csesarah/Rehabot2.0/misc/calib_img-5.jpg

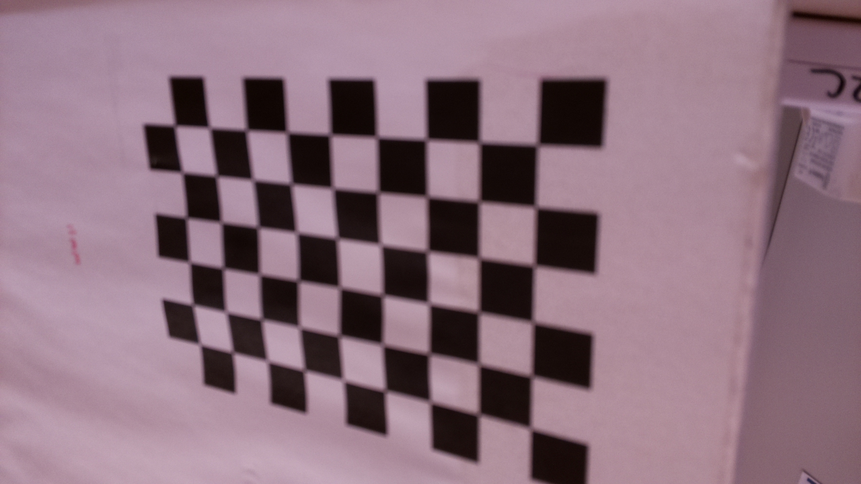
misc/calib_img-5.jpg
