csesarah/Rehabot2.0/misc/calib_img-4.jpg

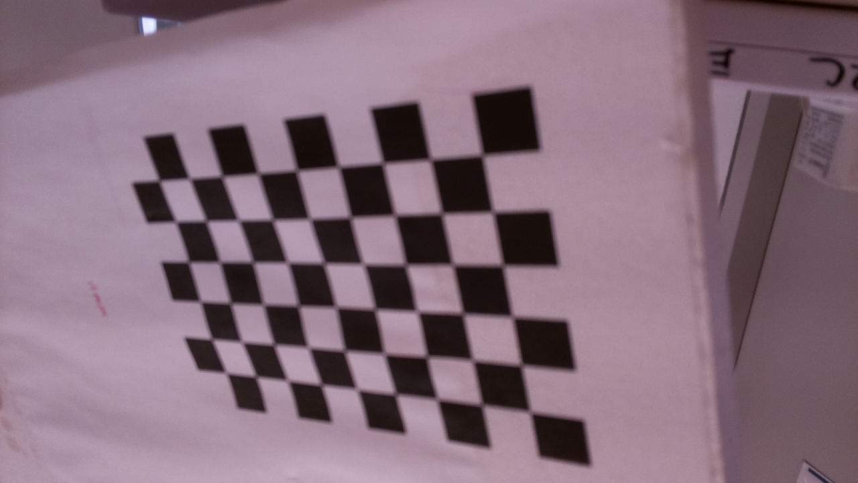
misc/calib_img-4.jpg
