csesarah/Rehabot2.0/misc/calib_img-0.jpg

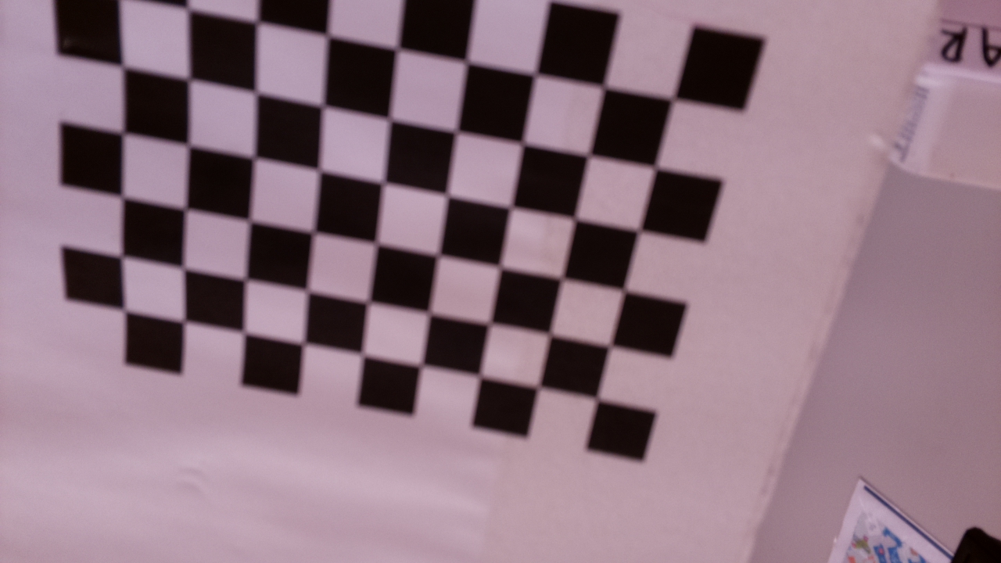
misc/calib_img-0.jpg
