csesarah/Rehabot2.0/misc/calib_img-1.jpg

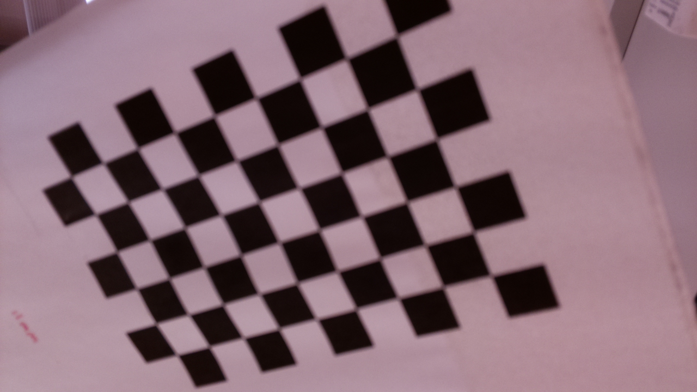
misc/calib_img-1.jpg
