csesarah/Rehabot2.0/misc/calib_img-2.jpg

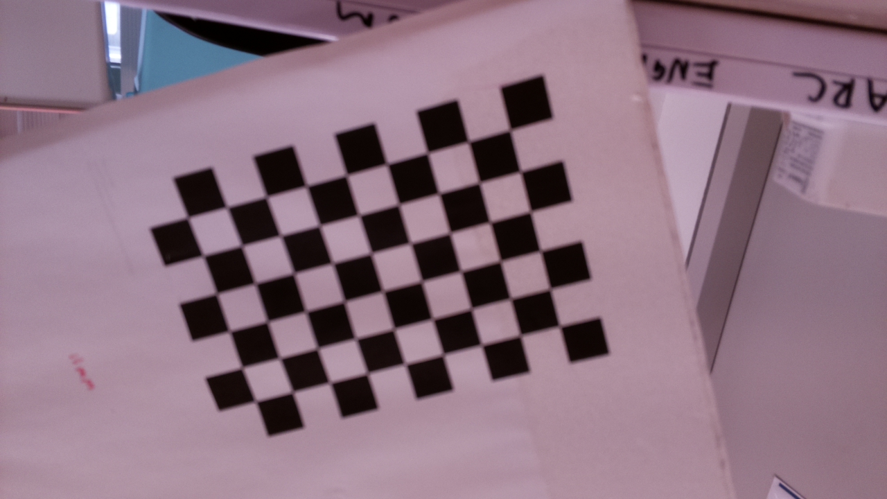
misc/calib_img-2.jpg
