csesarah/Rehabot2.0/misc/calib_img-3.jpg

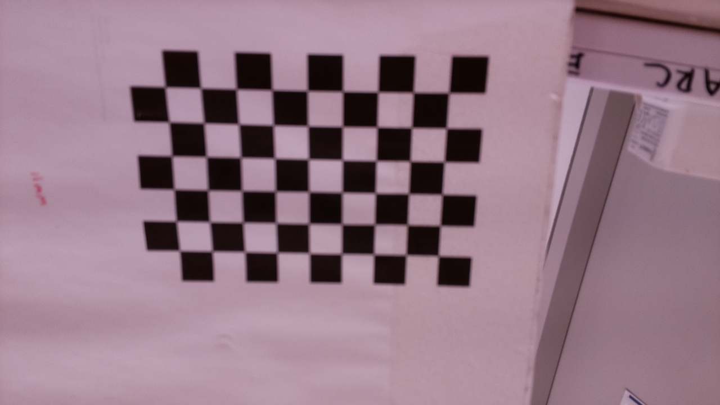
misc/calib_img-3.jpg
