csesarah/Rehabot2.0/misc/calib_img-6.jpg

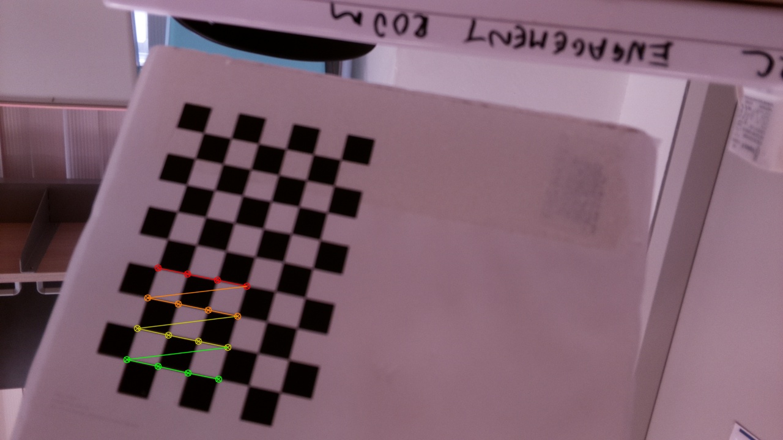
misc/calib_img-6.jpg
