csesarah/Rehabot2.0/misc/calib_img-7.jpg

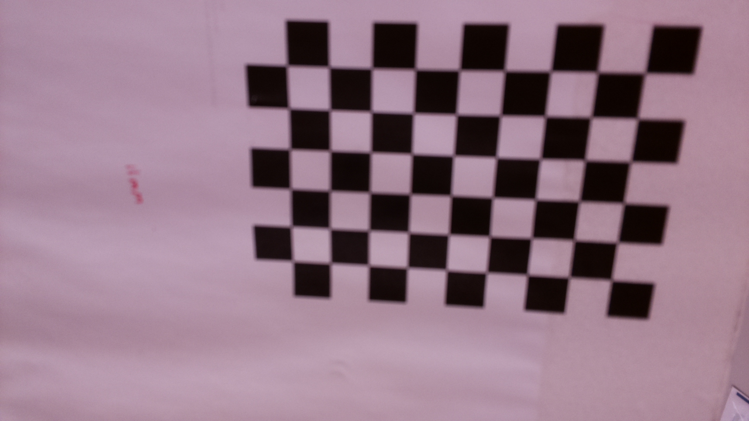
misc/calib_img-7.jpg
