csesarah/Rehabot2.0/misc/calib_img-8.jpg

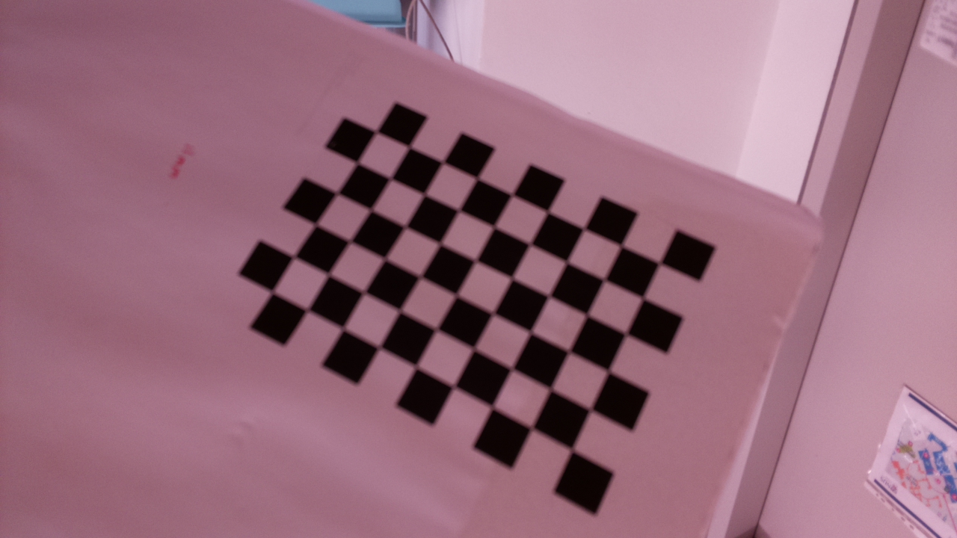
misc/calib_img-8.jpg
