csesarah/Rehabot2.0/misc/calib_img-9.jpg

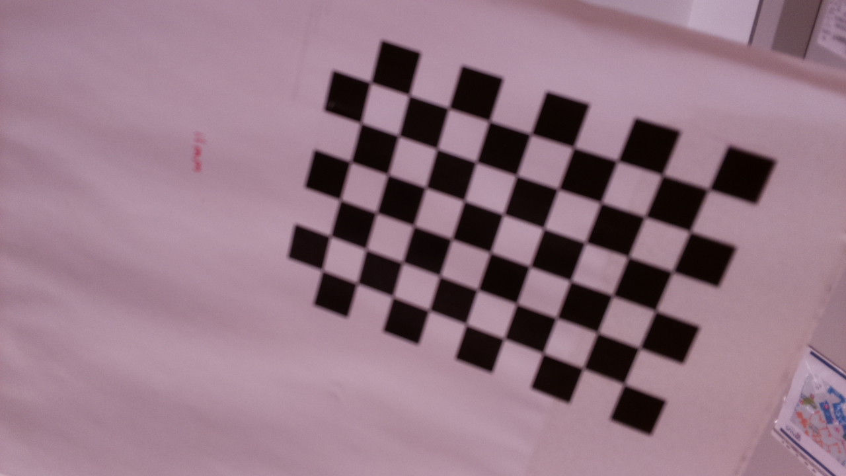
misc/calib_img-9.jpg
