csesarah/Rehabot2.0/rsc/img/wallpaper.png

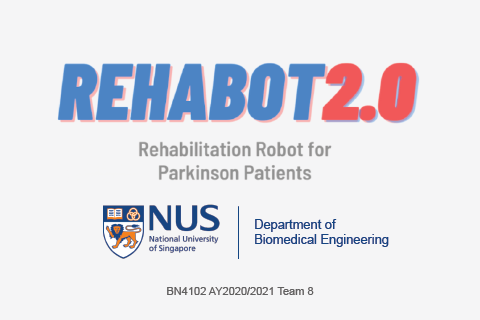
rsc/img/wallpaper.png
