csesarah/Rehabot2.0/ProductionManual.pdf

Rehabot2.0 Production Manual

1. 3D-print and preprocess casings and parts

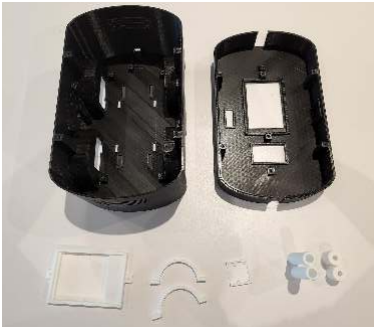
[picture p12: figure]

### 2. Print ArUco markers with IDs 0 and 1, and dictionary size of 5x5

### 3. Fold and tape paper markers and attach velcro to back of marker

### 4. Sew buckle and velcro to elastic bands as shown

### 5. Attach black support pieces to the motors

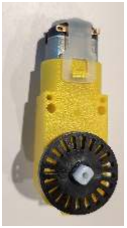
[picture p13: figure]

### 6. Solder wires to motors, and ensure that there are no exposed wires

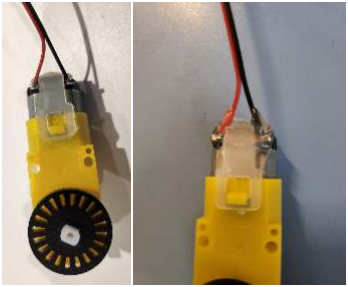
[picture p14: figure]

### 7. Attach motors to bottom casing with holders included in 4-wheel drive set

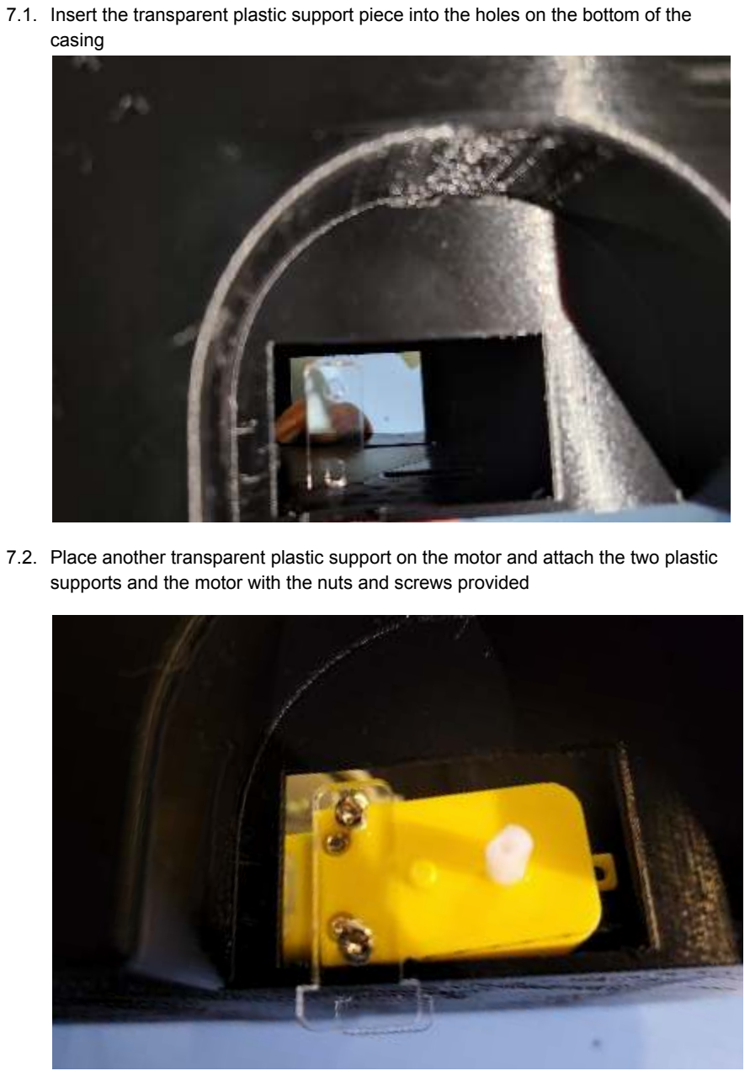
[picture p15: page 3]

### 7.1. Insert the transparent plastic support piece into the holes on the bottom of the

casing

### 7.2. Place another transparent plastic support on the motor and attach the two plastic

supports and the motor with the nuts and screws provided

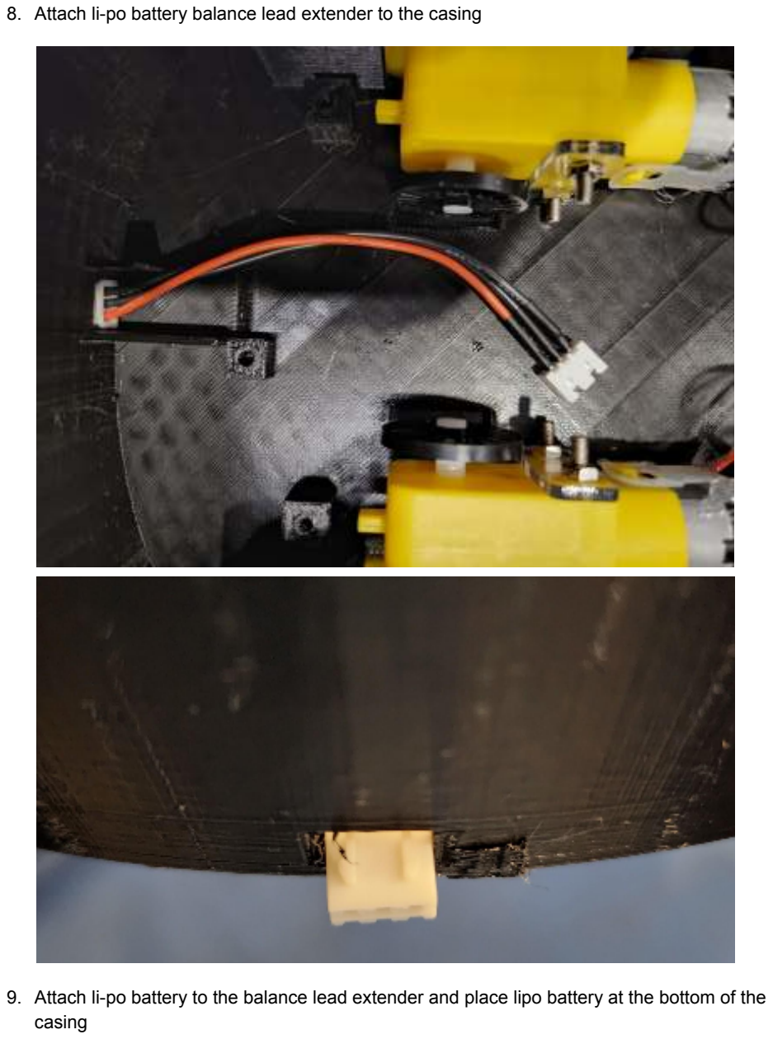
[picture p16: page 4]

### 8. Attach li-po battery balance lead extender to the casing

9. Attach li-po battery to the balance lead extender and place lipo battery at the bottom of the casing

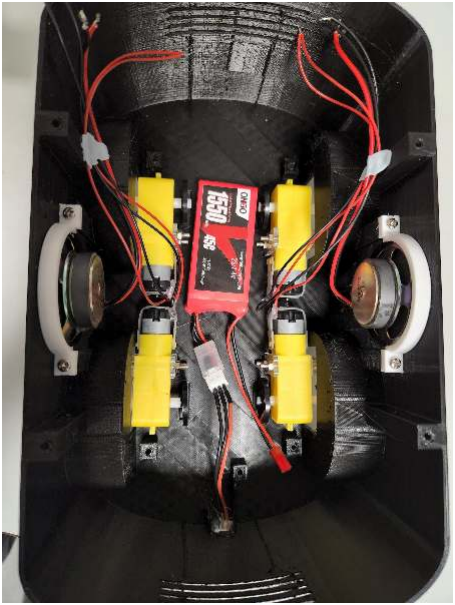
[picture p17: figure]

### 10. Screw support structure onto the bottom casing

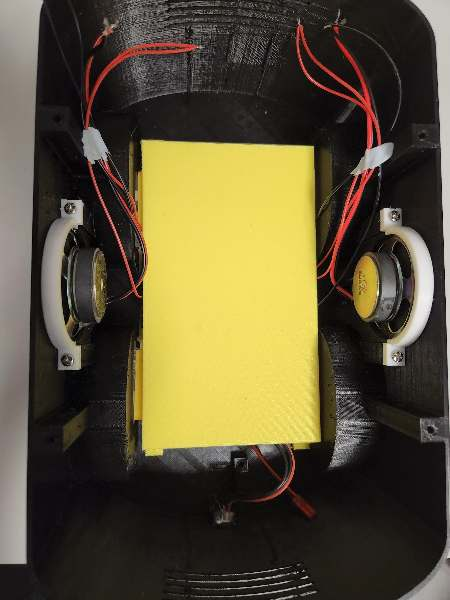
[picture p18: figure]

### 11. Solder the XL6009 step-up, LM2596 step-down, and 5V/3A USB step-down boards onto a

protoboard as shown

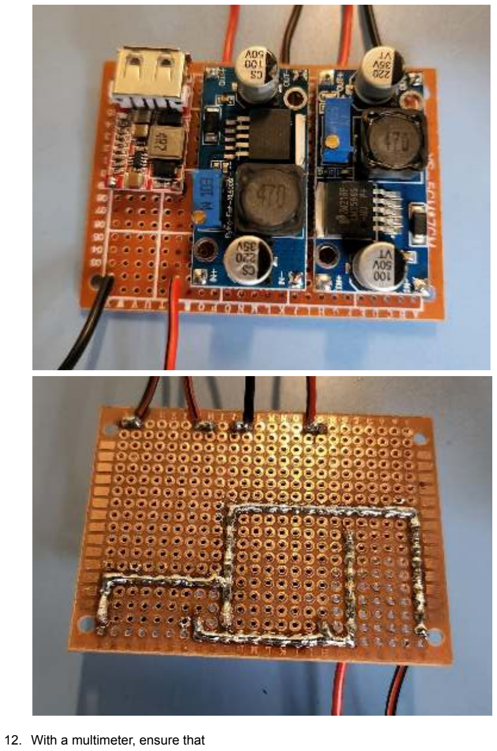
[picture p19: page 7]

### 12. With a multimeter, ensure that

### 12.1. Output voltage of the XL6009 is 12.0V, and

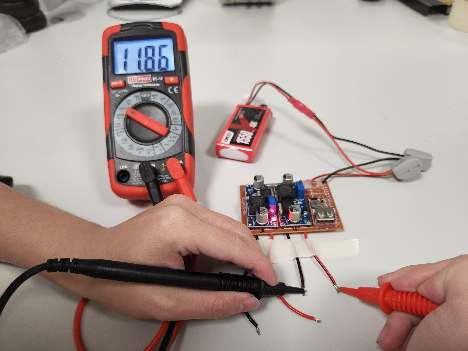
[picture p20: figure]

### 12.2. Output voltage of the LM2596 is 5.0V

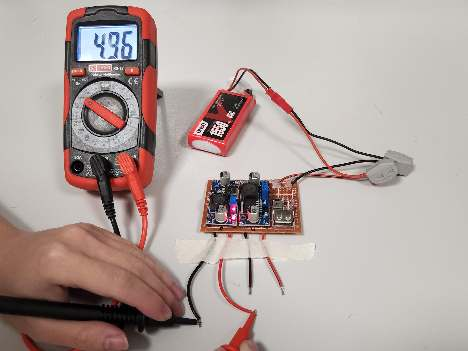
[picture p21: figure]

13. Unscrew the housing from the 3.5mm audio jack and solder the 3.5mm audio jack as shown, wherein ground is the longest terminal, and left and right are the terminals next to the ground terminal respectively

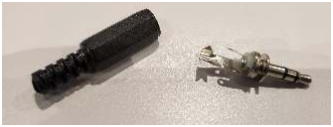
[picture p22: figure]
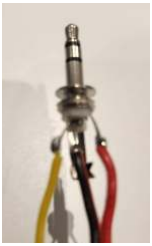
[picture p23: figure]

### 14. Thread audio jack housing through the audio cables and then solder the cables to the

PAM8403 speaker amplifier board

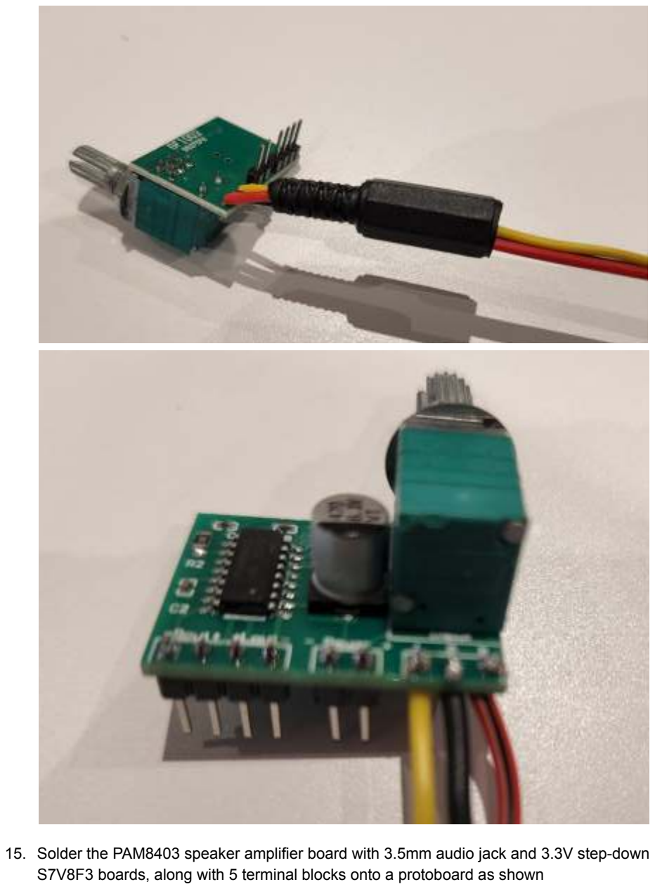
[picture p24: page 11]

### 15. Solder the PAM8403 speaker amplifier board with 3.5mm audio jack and 3.3V step-down

S7V8F3 boards, along with 5 terminal blocks onto a protoboard as shown

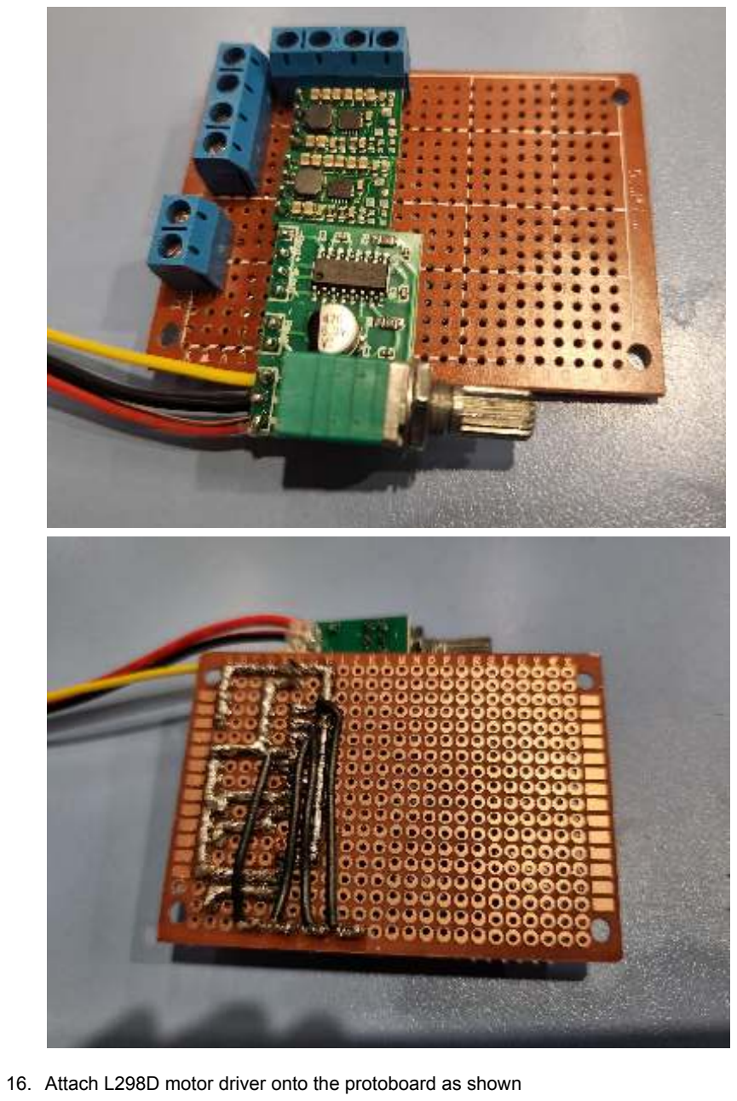
[picture p25: page 12]

### 16. Attach L298D motor driver onto the protoboard as shown

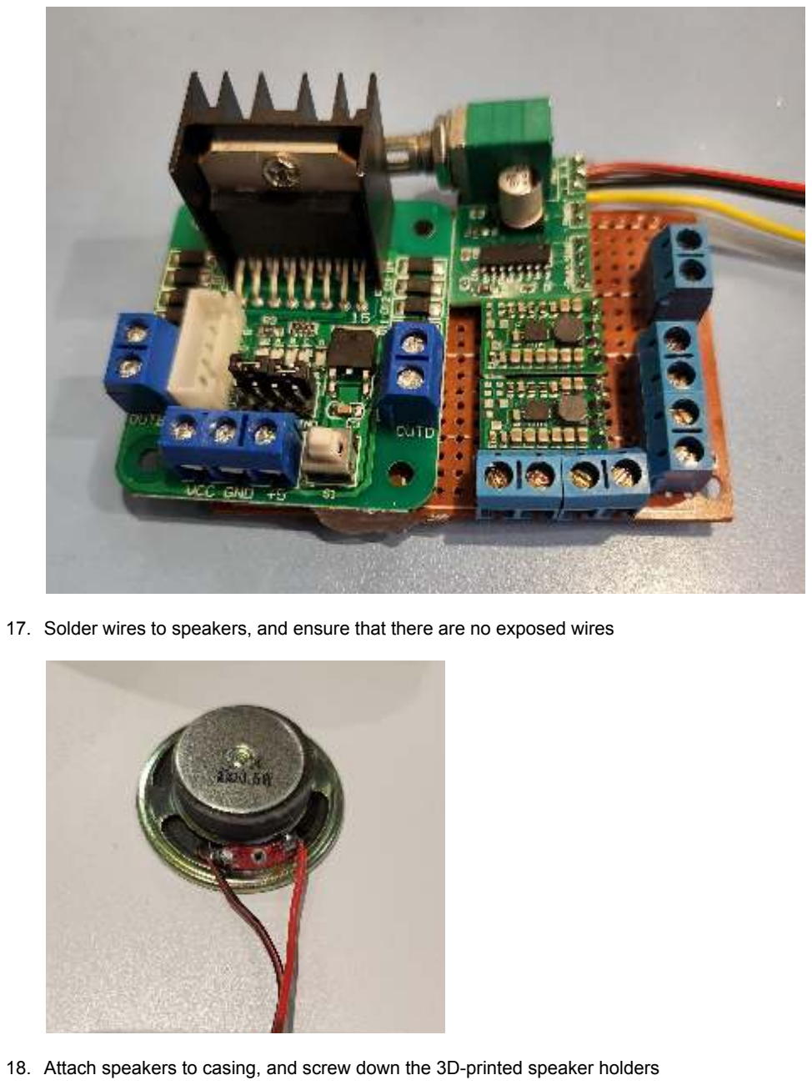
[picture p26: page 13]

### 17. Solder wires to speakers, and ensure that there are no exposed wires

### 18. Attach speakers to casing, and screw down the 3D-printed speaker holders

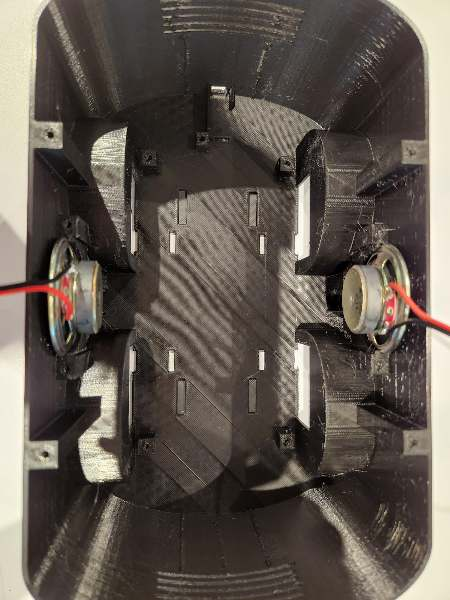
[picture p27: figure]

### 19. Connect the XL6009 step-up (12.0 V) to the motor driver as shown

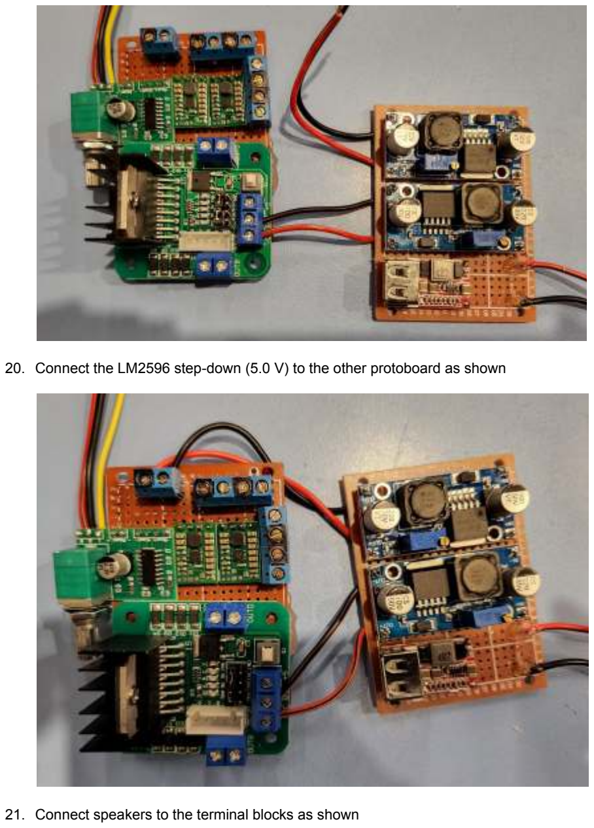
[picture p28: page 15]

### 20. Connect the LM2596 step-down (5.0 V) to the other protoboard as shown

### 21. Connect speakers to the terminal blocks as shown

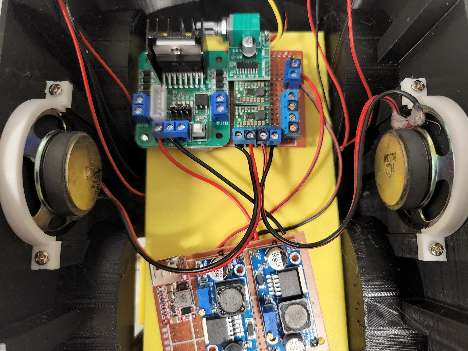
[picture p29: figure]

### 22. Connect motors to the motor driver as shown

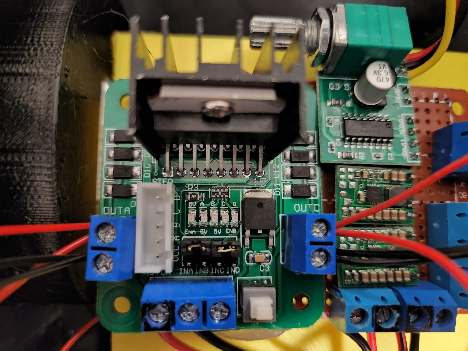
[picture p30: figure]

### 23. Attach line grating on to the green dot lasers

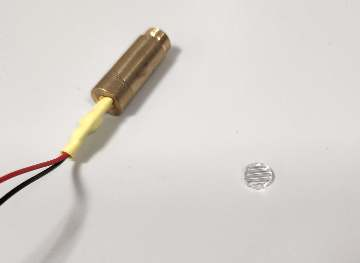
[picture p31: figure]

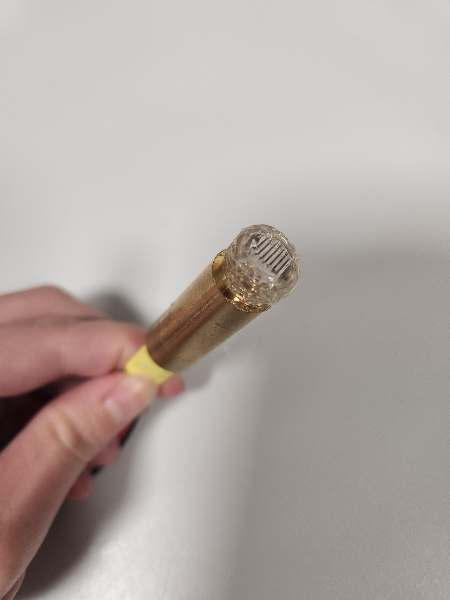
[picture p32: figure]

### 24. Place lasers in the laser holders

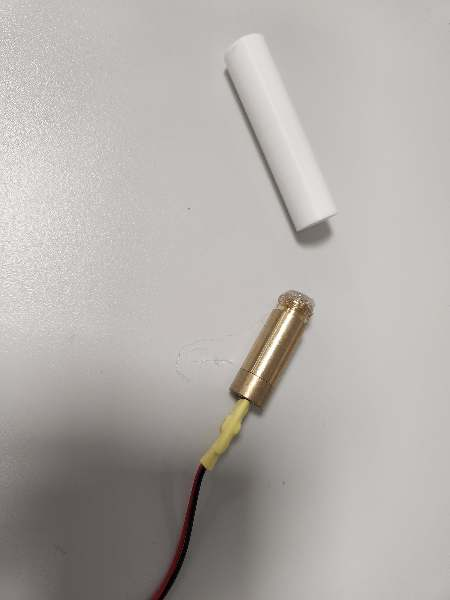
[picture p33: figure]

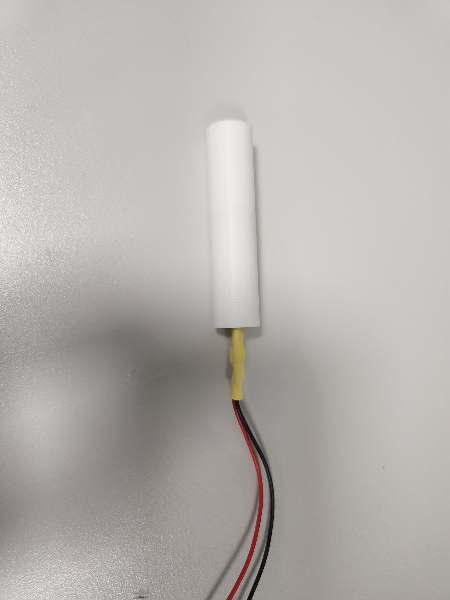
[picture p34: figure]

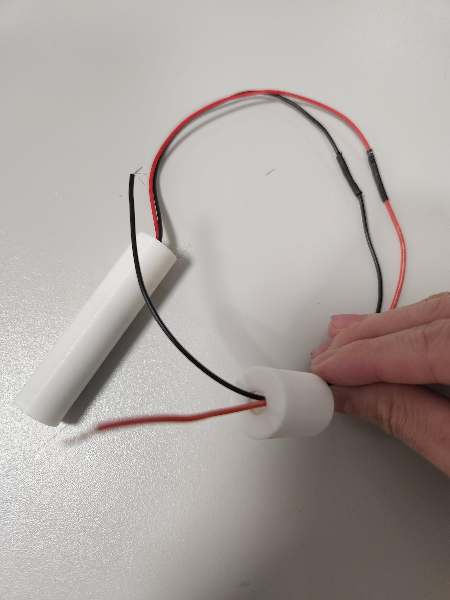
[picture p35: figure]

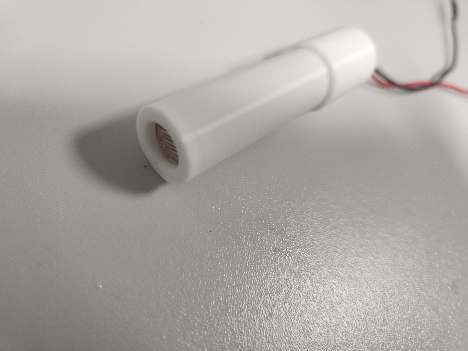
[picture p36: figure]

### 25. Connect lasers to the terminal blocks as shown

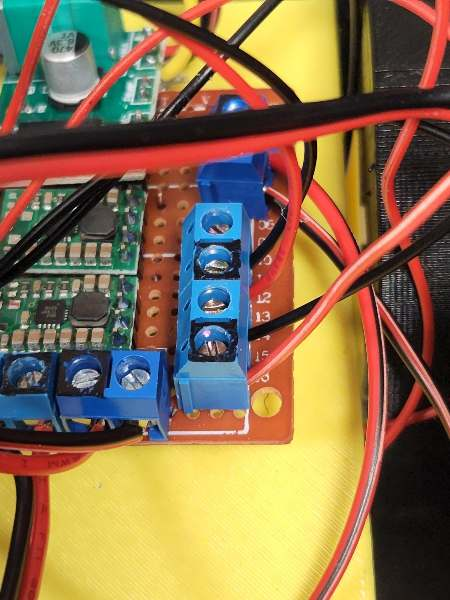
[picture p37: figure]

### 26. Burn firmware image onto microSD card

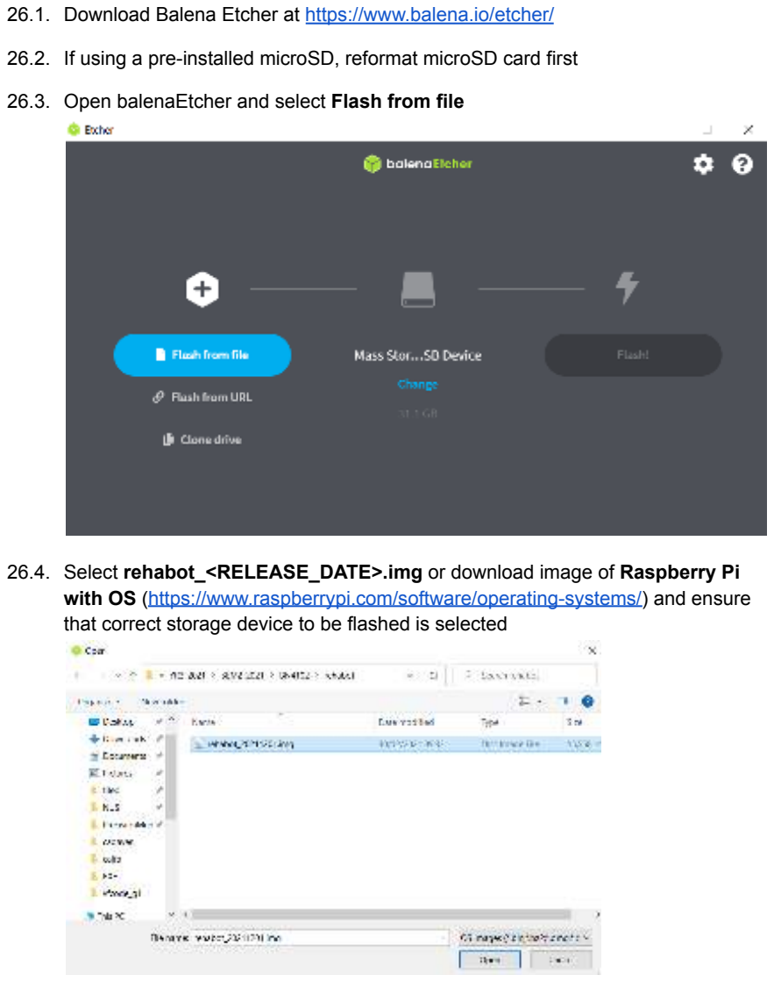
[picture p38: page 25]

### 26.1. Download Balena Etcher at https://www.balena.io/etcher/

### 26.2. If using a pre-installed microSD, reformat microSD card first

### 26.3. Open balenaEtcher and select Flash from file

### 26.4. Select rehabot_<RELEASE_DATE>.img or download image of Raspberry Pi

with OS (https://www.raspberrypi.com/software/operating-systems/) and ensure that correct storage device to be flashed is selected

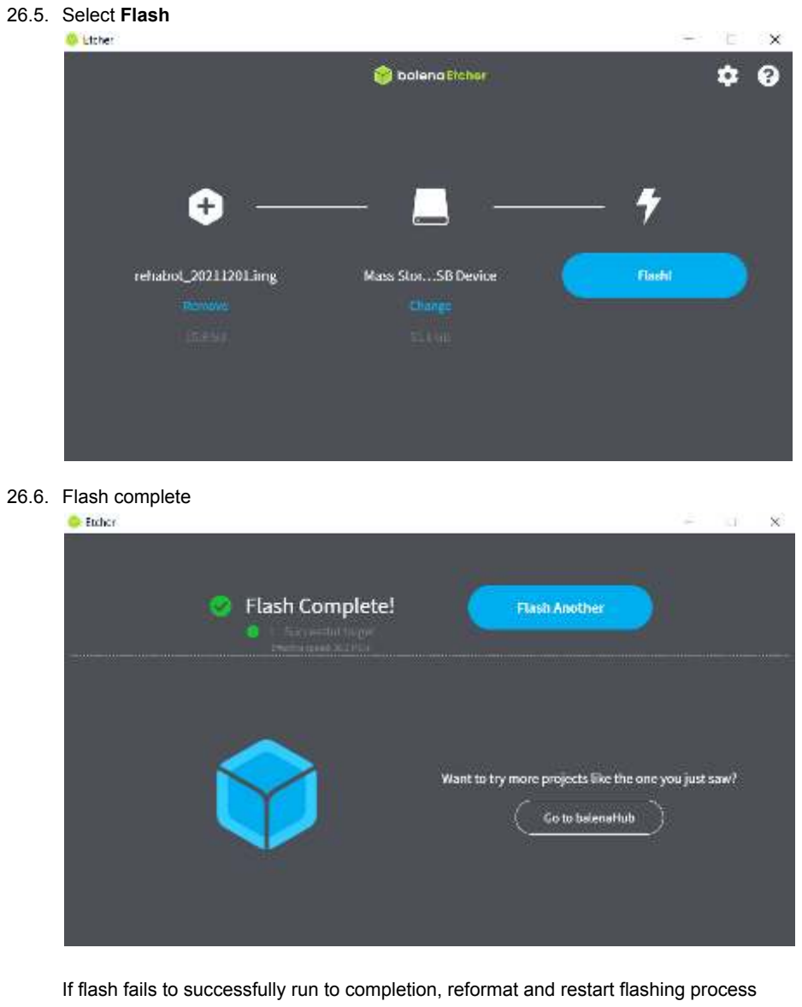
[picture p39: page 26]

### 26.5. Select Flash

### 26.6. Flash complete

If flash fails to successfully run to completion, reformat and restart flashing process

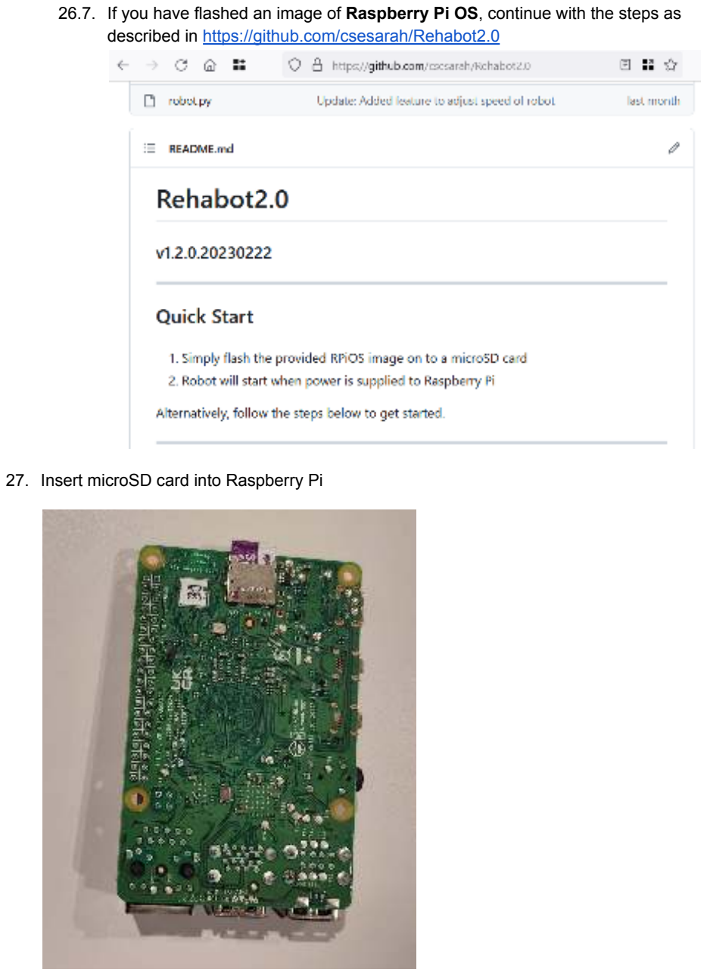
[picture p40: page 27]

### 26.7. If you have flashed an image of Raspberry Pi OS, continue with the steps as

described in https://github.com/csesarah/Rehabot2.0

### 27. Insert microSD card into Raspberry Pi

### 28. Attach camera to the Raspberry Pi

### 28.1. Gently pull up on the edges of the port’s plastic clip

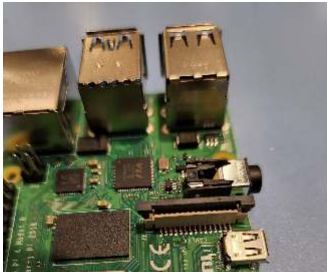
[picture p41: figure]

### 28.2. Insert the Camera Module ribbon cable and make sure the connectors at the

bottom of the ribbon cable are facing the contacts in the port (words printed on the cable facing Ethernet port if using original ribbon cable of Raspberry Pi V2 camera, words printed on the cable facing away from Ethernet port if using extender ribbon cable)

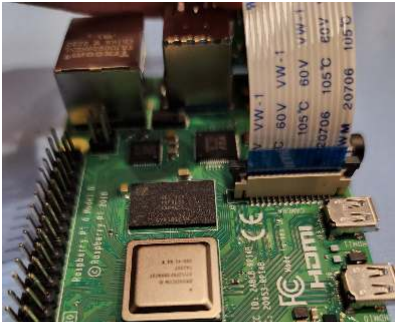
[picture p42: figure]

28.3. Push the plastic clip back into place and ensure that ribbon cable is well-connected

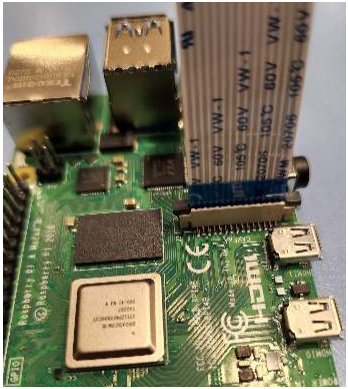
[picture p43: figure]

### 29. Connect USB-C to USB cable from the 5V/3A USB step-down board to the Raspberry Pi

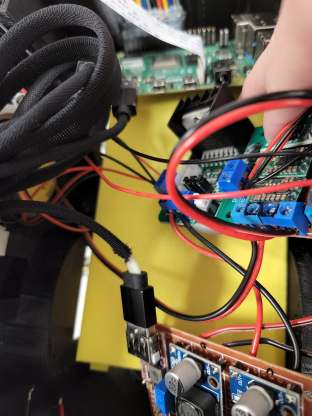
[picture p44: figure]

### 30. Connect 3.5mm audio jack to the Raspberry Pi

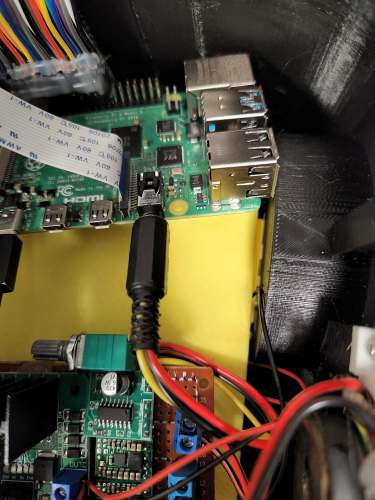
[picture p45: figure]

31. Connect the motor driver to the Raspberry Pi with female-female dupont wires as shown:
- GPIO pins 6, 13, 19, 26 to driver input pins
- GPIO pins 16, 20 to driver enable A and B pins (if there are jumpers on the enable pins on motor driver, disconnect jumpers first)

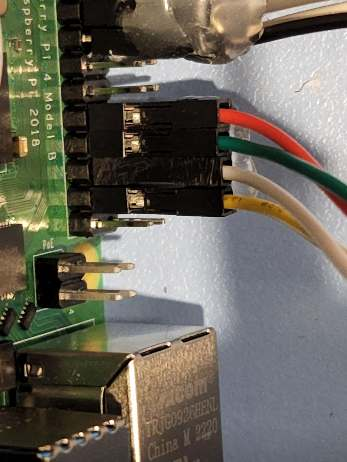
[picture p46: figure]

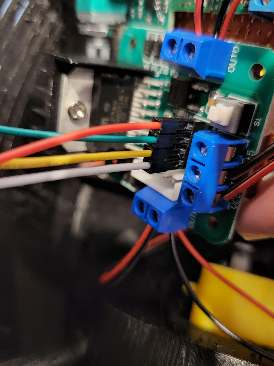
[picture p47: figure]

### 32. Attach camera and camera holder onto the top casing

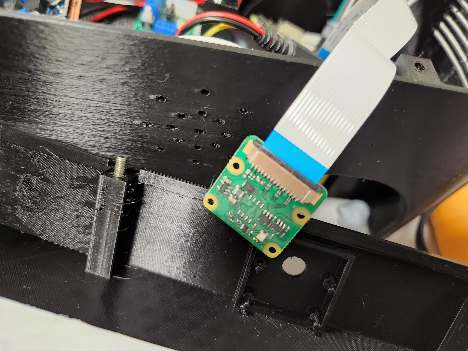
[picture p48: figure]

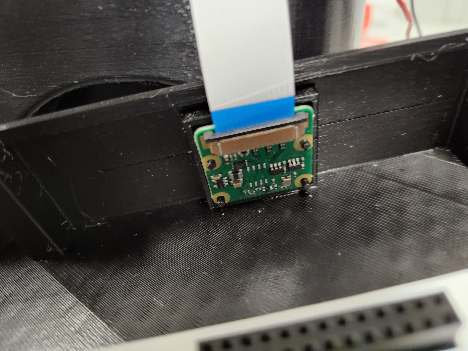
[picture p49: figure]

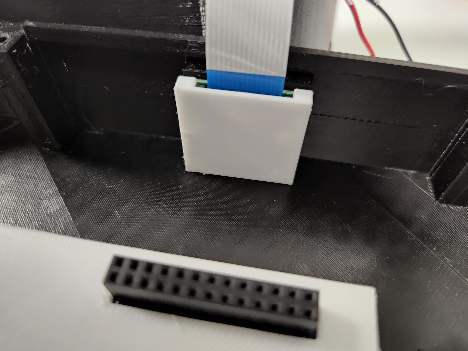
[picture p50: figure]

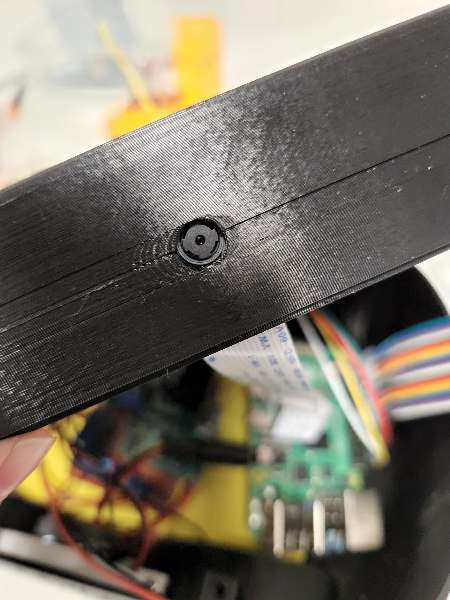
[picture p51: figure]

### 33. Attach touchscreen to the top casing

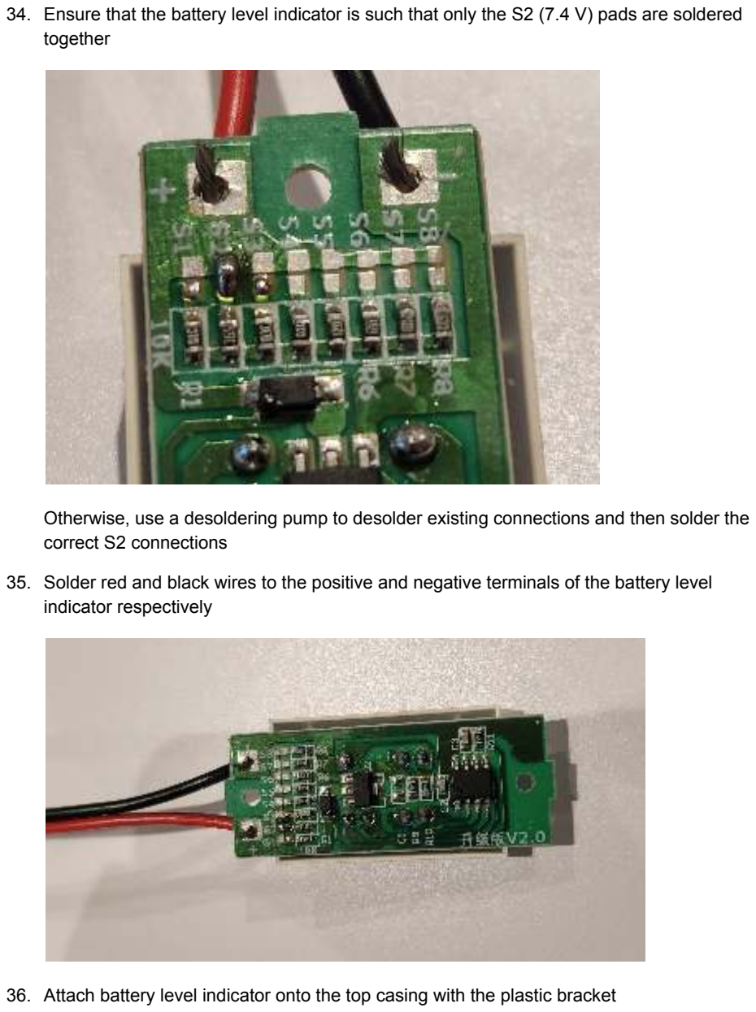
[picture p52: page 39]

34. Ensure that the battery level indicator is such that only the S2 (7.4 V) pads are soldered together

Otherwise, use a desoldering pump to desolder existing connections and then solder the correct S2 connections
35. Solder red and black wires to the positive and negative terminals of the battery level indicator respectively

### 36. Attach battery level indicator onto the top casing with the plastic bracket

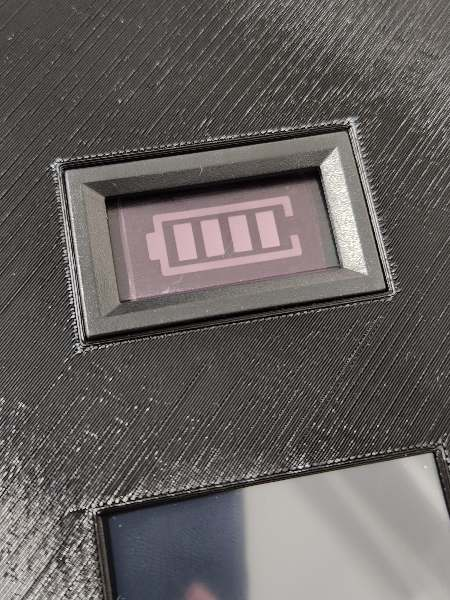
[picture p53: figure]

### 37. Attach rocker switch to the top casing and Solder wires to the rocker switch as shown

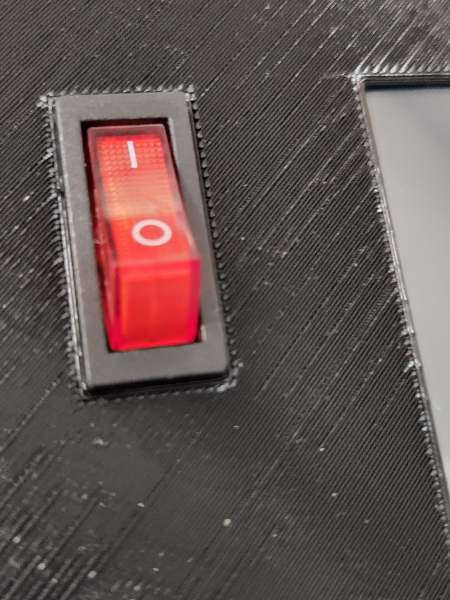
[picture p54: figure]

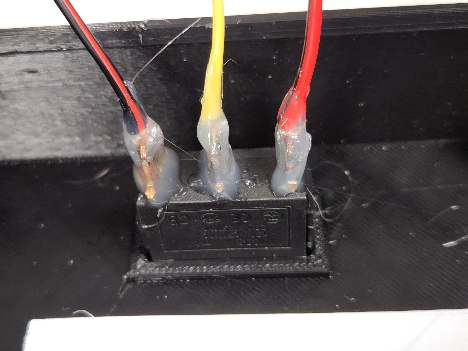
[picture p55: figure]

### 38. Connect the touchscreen to the Raspberry Pi with male-female dupont cables

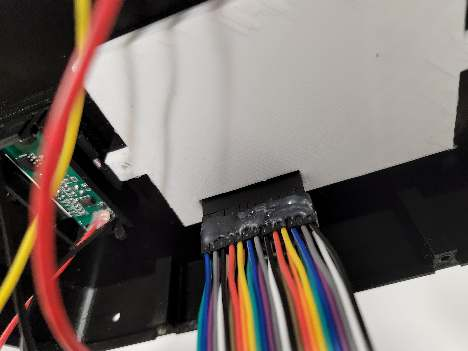
[picture p56: figure]

### 39. Connect all ground cables, to ground cable of li-po battery

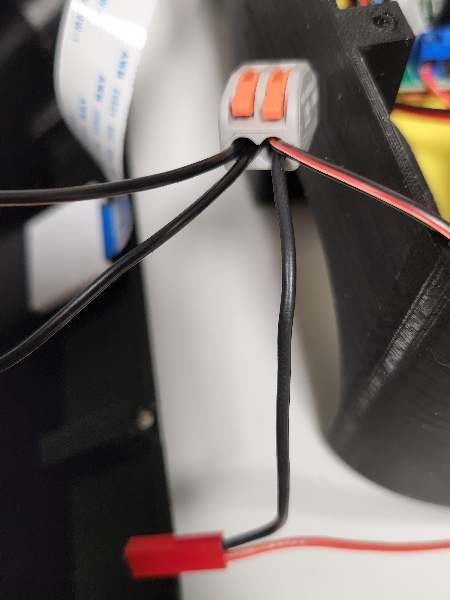
[picture p57: figure]

### 40. Connect power cable of lipo-battery to switch

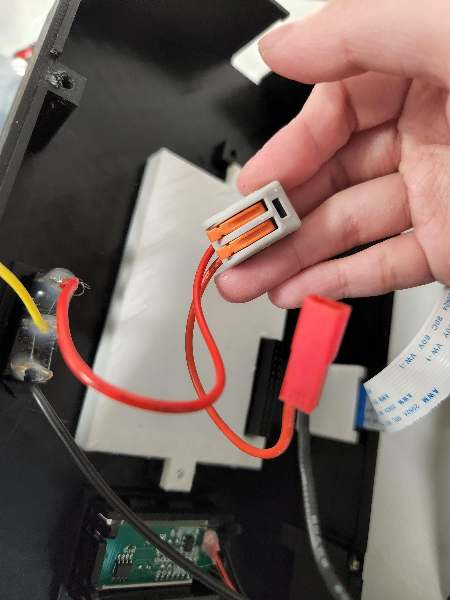
[picture p58: figure]

### 41. Connect all power cables to switch

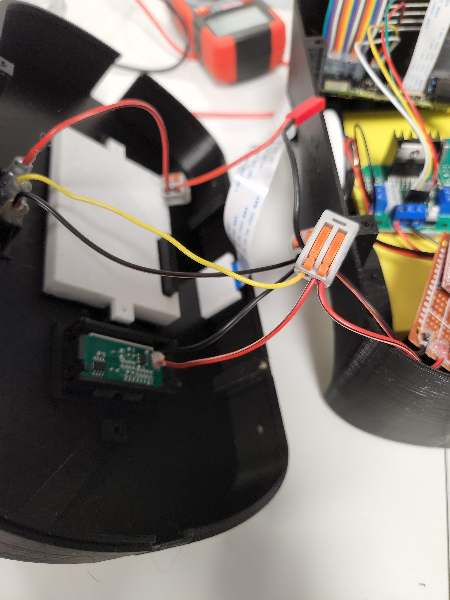
[picture p59: figure]

### 42. Connect the battery to the JST connector

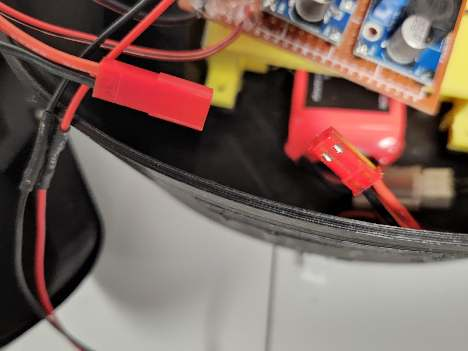
[picture p60: figure]

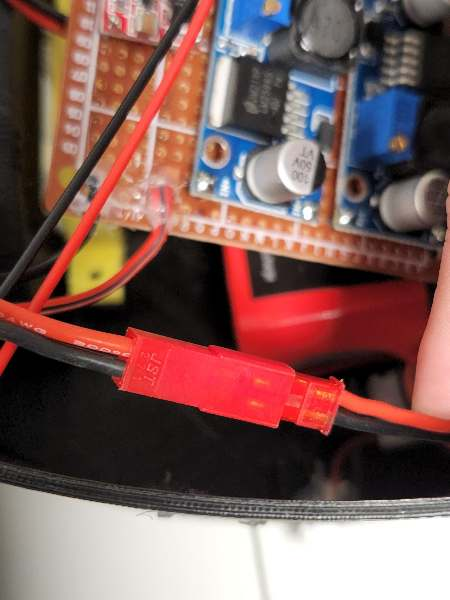
[picture p61: figure]

### 43. Power on and ensure that device is working

### 43.1. Touchscreen is responsive to touches

### 43.2. Sound emitted from speakers can be heard clearly

Otherwise, check that volume controller on the PAM8403 board is turned up to the loudest possible volume, and check audio jack connections

### 43.3. Camera can detect markers and robot moves in the correct direction when markers

are detected (ie. wheels do not move in opposite direction)

If wheels are moving in opposite direction, check motor drive to Raspberry Pi connection

### 43.4. Powers off when switch offed

44. Align and attach lasers to the top casing such that they are at least 0.3 m away and parallel to the front and back of the robot respectively

### 45. Screw down top casing to bottom casing
