csesarah/Rehabot2.0/misc/move.py

import curses
from gpiozero import Robot

robot = Robot(left=(26,19), right=(13,6))
GPIO.setup(16, GPIO.OUT)
GPIO.setup(20, GPIO.OUT)
GPIO.output(16, GPIO.LOW)
GPIO.output(20, GPIO.LOW)
GPIO.output(16, GPIO.HIGH)
GPIO.output(20, GPIO.HIGH)

actions = {
    curses.KEY_UP:    robot.forward,
    curses.KEY_DOWN:  robot.backward,
    curses.KEY_LEFT:  robot.left,
    curses.KEY_RIGHT: robot.right,
    }


def main(window):
    next_key = None
    while True:
        curses.halfdelay(1)
        if next_key is None:
            key = window.getch()
        else:
            key = next_key
            next_key = None
        if key != -1:
            # KEY DOWN
            curses.halfdelay(3)
            action = actions.get(key)
            if action is not None:
                action()
            next_key = key
            while next_key == key:
                next_key = window.getch()
            # KEY UP
            robot.stop()
curses.wrapper(main)
